Hammer000/SJ-key/hardware/SJ-key_4key/schematic/20261031_SCH_Main_PCB_4key.pdf

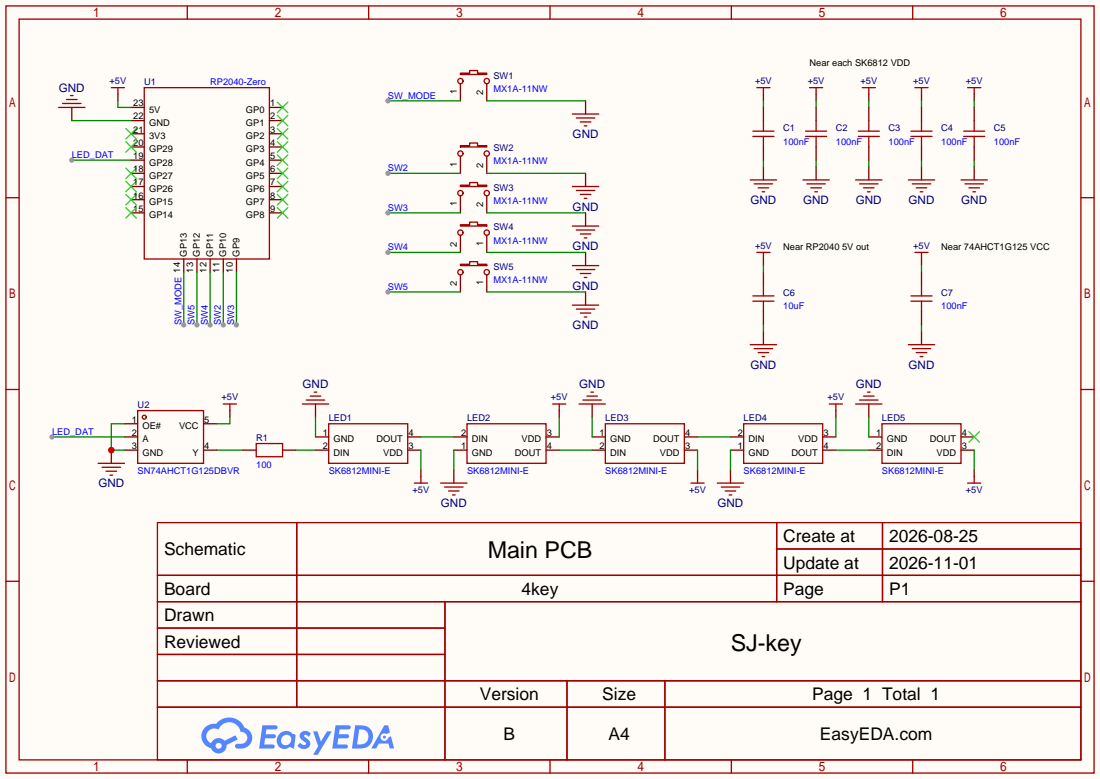
[picture p4: page 1]

Schematic | Main PCB | Create at | 2026-08-25

Update at | 2026-11-01

Board | 4key | Page | P1
Drawn | | SJ-key
Reviewed

Version | Size | Page 1 Total 1
B | A4 | EasyEDA.com
